Chanbadar/DIY_particle_detector/hardware/V1.2/DIY_detector.sch

## KiCad design hardware/V1.2/DIY_detector.sch (2026-06-24)

Schematic: DIY_detector.sch

Parts:
BT1: 9V battery clip; MFG_PN FC6830; FARNELL 2817539
C1: 1p; C_Disc_D3.0mm_W1.6mm_P2.50mm; MFG_PN MC0805N100J101A2.54MM; FARNELL 1694175
C2: DNP; C_Disc_D3.0mm_W1.6mm_P2.50mm; MFG_PN MC0805N100J101A2.54MM; FARNELL 1694175
C3, C5, C7, C10: 100n; C_Disc_D3.0mm_W1.6mm_P2.50mm; MFG_PN MC0805Y104M500A2.54MM; FARNELL 2112751
C4: 100n; C_Disc_D3.0mm_W1.6mm_P2.50mm; MFG_PN C320C474M5U5TA; FARNELL 1457660
C6: 100p; C_Disc_D3.0mm_W1.6mm_P2.50mm; MFG_PN TS170R1H332KSBBA0R; FARNELL 2901293
C8: 10u; CP_Radial_D6.3mm_P2.50mm; MFG_PN ECA-1JHG470; FARNELL 9693033
C9: 6n8; C_Disc_D3.0mm_W1.6mm_P2.50mm; MFG_PN TS170R1H682KSBBA0R; FARNELL 2901297
C_bias: 1u; C_Disc_D3.0mm_W1.6mm_P2.50mm
D1: BPX61; PhotoDiode_DIL2_4.3x4.65_RM5.08; MFG_PN BPW34F/FA; FARNELL 2981621
D2, D3: DNP; PhotoDiode_DIL2_4.3x4.65_RM5.08; MFG_PN BPW34F/FA; FARNELL 2981621
D4: DNP; PhotoDiode_DIL2_4.3x4.65_RM5.08; MFG_PN BPX61; FARNELL 2981630
J1, J2: Conn_01x02_Female; Pin_Header_Straight_1x02_Pitch2.54mm
J3: BNC socket; MFG_PN 13-25; FARNELL 1169699
MK1, MK2, MK3, MK4: via for coincidence sandwich; SolderWirePad_single_0-8mmDrill
MK5, MK6, MK7: M3 support; MountingHole_3.2mm_M3_ISO7380_Pad
R1: 4k7; R_Axial_DIN0207_L6.3mm_D2.5mm_P7.62mm_Horizontal; MFG_PN MCMF006FF4701A50; FARNELL 2401772
R2: 15k; R_Axial_DIN0207_L6.3mm_D2.5mm_P7.62mm_Horizontal; MFG_PN MCMF006FF1502A50; FARNELL 2401785
R3: 22M; R_Axial_DIN0204_L3.6mm_D1.6mm_P2.54mm_Vertical; MFG_PN RH73H2A40MKTN; FARNELL 1174521
R4: 1k; R_Axial_DIN0207_L6.3mm_D2.5mm_P7.62mm_Horizontal; MFG_PN MCMF006FF4701A50; FARNELL 2401772
R5: 1M; R_Axial_DIN0207_L6.3mm_D2.5mm_P7.62mm_Horizontal; MFG_PN MCMF006FF1004A50; FARNELL 2401807
R6, R7, R8: 10k; R_Axial_DIN0207_L6.3mm_D2.5mm_P10.16mm_Horizontal; MFG_PN MCMF006FF1002A50; FARNELL 2401780
R9: 2k2; R_Axial_DIN0207_L6.3mm_D2.5mm_P10.16mm_Horizontal; MFG_PN MCMF006FF2201A50; FARNELL 2401780
RV1: 10k; Potentiometer_Trimmer_Bourns_3296W_Vertical
R_bias: 100k; R_Axial_DIN0207_L6.3mm_D2.5mm_P7.62mm_Horizontal
SW1: -; MFG_PN 1MS1T1B1M1QE; FARNELL 9473416
U1: TLE2072; DIP-8_W7.62mm_LongPads; MFG_PN TLE2072ACP; FARNELL 3117956
U2: TLV3201; SOT-23-5; MFG_PN TLV3201AIDCKT

Notes on the sheet:
one 5 pF capcitor can be used alternativly, C1 or C2 must be shorted in this case with solder, a piece of wire or a 0 Ohm resistor
Suitable aluminium die-cast enclosures (besides your favourite candy tin box): Multicomp G102MF (Farnell nr. 1902552), fits precisely including edge mount screws http://uk.farnell.com/multicomp/g102mf/box-diecast-90x36x30mm/dp/1902552 Deltron 480-0010 (Farnell nr. 1774842), no mounting holes inside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
For measuring characteristic energies of alpha particles, one BPX61 with a destroyed glass window is needed. Alternatively up to 4 x BPW34F(A) diodes can be populated (like in V1.1). In this case only electrons will be detectable plus few gamma photons as with the BPX61. The advantages of using 4 x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
The passive low-pass filter R8/C9 limits the high frequency band for the largest & steep alpha particle signal peaks. The output filter C10/R9 matches the impedance such that an external microphone is recognzied with modern headset sockets of laptops and mobile phones (c.f. 4-pin mini-jack connecto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
case-mounted parts
R3 should be either an SMD 0805 part (preferred) or a vertically mounted regular leaded resistor (THT part)
All hardware & software source files plus detailed instructions on: www.github.com/ozel/DIY_particle_detector Details on the physics of the sensors & reference measurements: www.mdpi.com/1424-8220/19/19/4264 (www.doi.org/10.3390/s19194264)
