Chanbadar/DIY_particle_detector/(commit log)

2026-05-06 projeyi bastan duzenledim
    [pulses_raw_2026-05-06_11-27-34.csv]
2026-06-24 İlk commit: Proje dosyaları eklendi
    [DIY_detector.sch, pulses_raw_2026-05-06_11-27-34.csv]
