Chanbadar/DIY_particle_detector/(notices)

Notices in the files:
hardware/V1.2/DIY_detector.sch:
CERN Open Hardware License (CERN OHL V1.2)
